CC-Ian/Digital-D20/Mainboard/mainboard.kicad_pcb

## KiCad design Mainboard/mainboard.kicad_pcb (2025-07-16)

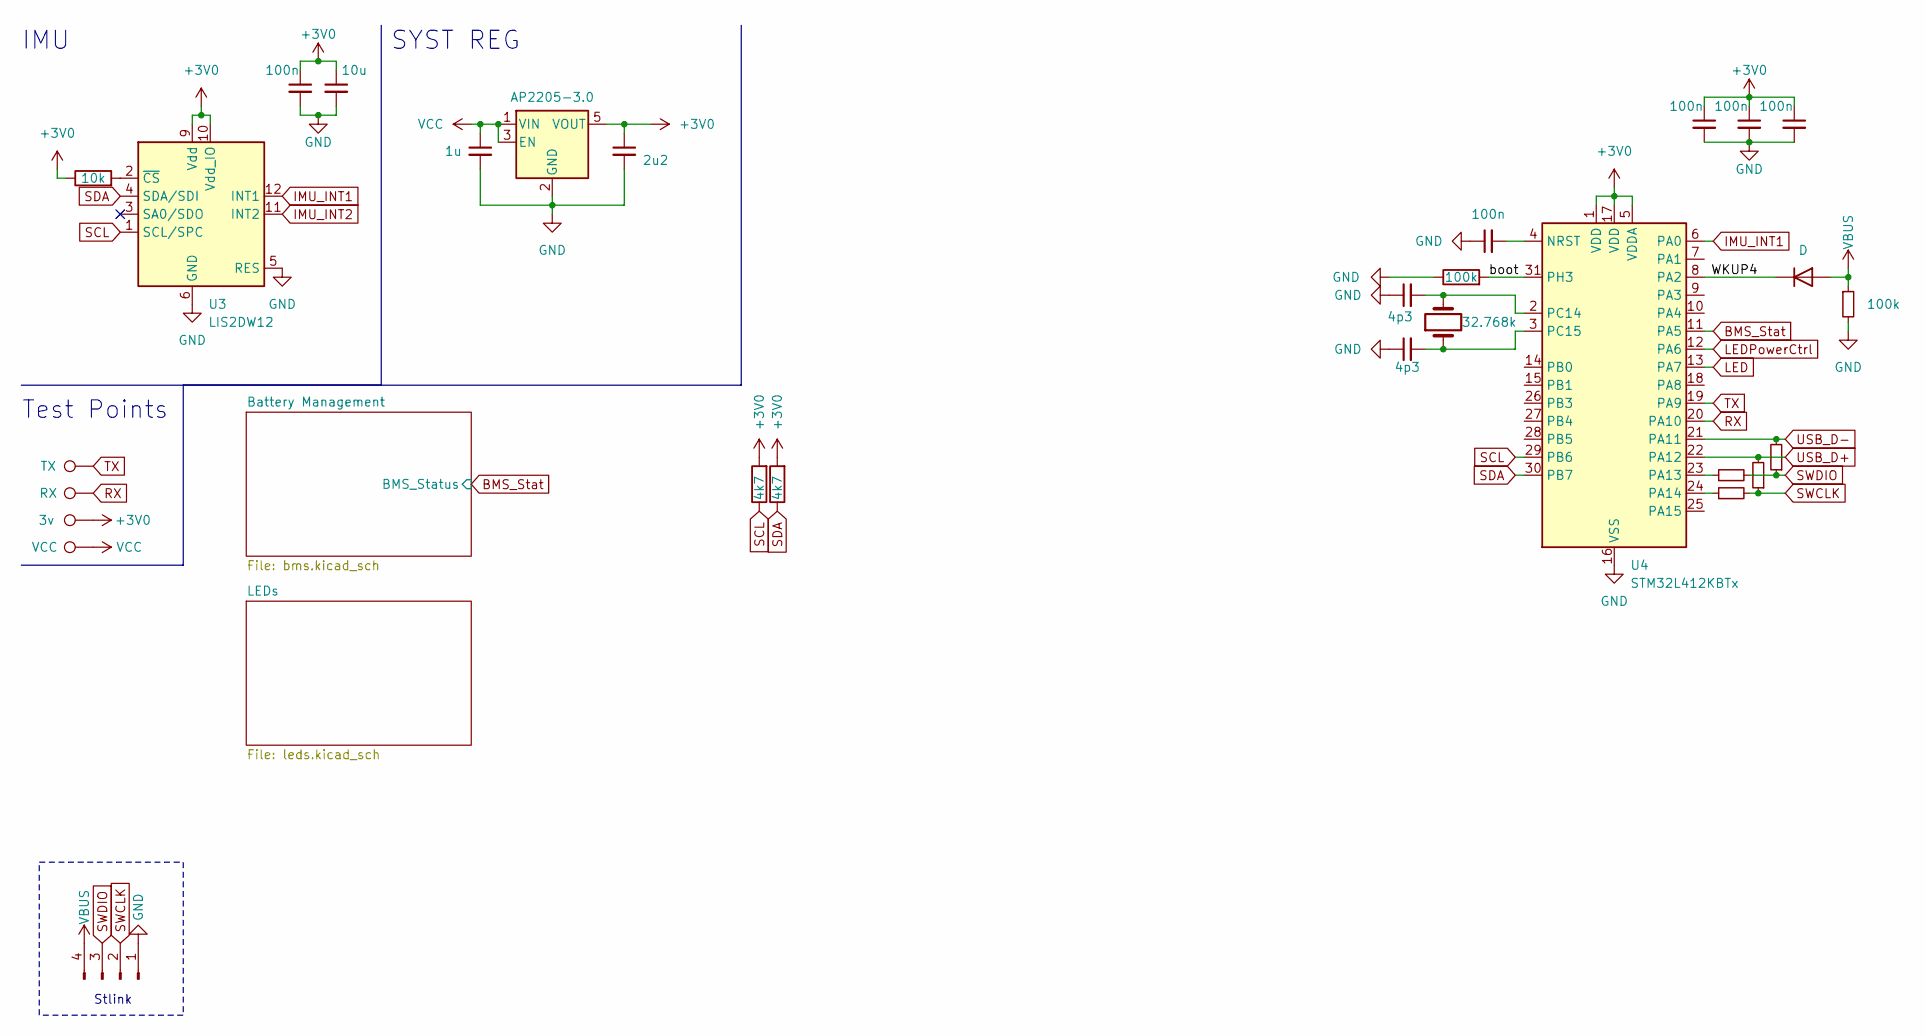
[picture p1: schematic mainboard.kicad_sch]

Parts:
3v0: 3v; TestPoint_Pad_D1.0mm
C3, C5, C6, C7, C10: 100n; C_0402_1005Metric
C4: 10u; C_0402_1005Metric
C8: 1u; C_0402_1005Metric
C9: 2u2; C_0402_1005Metric
C12, C13: 4p3; C_0402_1005Metric
D33: D; D_SOD-323
J1: Conn_01x04_Pin; PinHeader_1x04_P2.54mm_Vertical
R2: 10k; R_0402_1005Metric
R3, R12: R_Small; R_0201_0603Metric
R4, R10: 100k; R_0402_1005Metric
R6, R7: 4k7; R_0402_1005Metric
R13, R14: R_Small; R_0402_1005Metric
RX1: RX; TestPoint_Pad_D1.0mm
TP9: VCC; TestPoint_Pad_D1.0mm
TX1: TX; TestPoint_Pad_D1.0mm
U1: AP2205-3.0; SOT-23-5
U3: LIS2DW12; LGA-12_2x2mm_P0.5mm
U4: STM32L412KBTx; LQFP-32_7x7mm_P0.8mm
Y1: 32.768k; Crystal_SMD_3215-2Pin_3.2x1.5mm

Connections:
+3V0: 3v0.1, C3.1, C4.1, C5.1, C6.1, C7.1, C9.1, R2.1, R6.2, R7.2, U1.5 (VOUT), U3.9 (Vdd), U3.10 (Vdd_IO), U4.1 (VDD), U4.5 (VDDA), U4.17 (VDD)
/WKUP4: D33.1 (K), U4.8 (PA2)
/boot: R4.2, U4.31 (PH3)
BMS_Stat: U4.11 (PA5); also elsewhere on the board
GND: C3.2, C4.2, C5.2, C6.2, C7.2, C8.2, C9.2, C10.1, C12.1, C13.1, J1.1, R4.1, R10.2, U1.2 (GND), U3.5 (RES), U3.6 (GND), U3.7 (GND), U3.8 (GND), U4.16 (VSS), U4.32 (VSS); also elsewhere on the board
IMU_INT1: U3.12 (INT1), U4.6 (PA0)
IMU_INT2: U3.11 (INT2)
LED: U4.13 (PA7); also elsewhere on the board
LEDPowerCtrl: U4.12 (PA6); also elsewhere on the board
unnamed: R2.2, U3.2 (~CS)
unnamed: C10.2, U4.4 (NRST)
unnamed: R3.1, U4.23 (PA13)
unnamed: R12.1, U4.24 (PA14)
unnamed: C12.2, U4.2 (PC14), Y1.2
unnamed: C13.2, U4.3 (PC15), Y1.1
RX: RX1.1, U4.20 (PA10)
SCL: R6.1, U3.1 (SCL/SPC), U4.29 (PB6)
SDA: R7.1, U3.4 (SDA/SDI), U4.30 (PB7)
SWCLK: J1.2, R12.2, R13.1
SWDIO: J1.3, R3.2, R14.1
TX: TX1.1, U4.19 (PA9)
USB_D+: R13.2, U4.22 (PA12)
USB_D-: R14.2, U4.21 (PA11)
VBUS: D33.2 (A), J1.4, R10.1; also elsewhere on the board
VCC: C8.1, TP9.1, U1.1 (VIN), U1.3 (EN); also elsewhere on the board

Notes on the sheet:
Test Points
SYST REG
Stlink
IMU

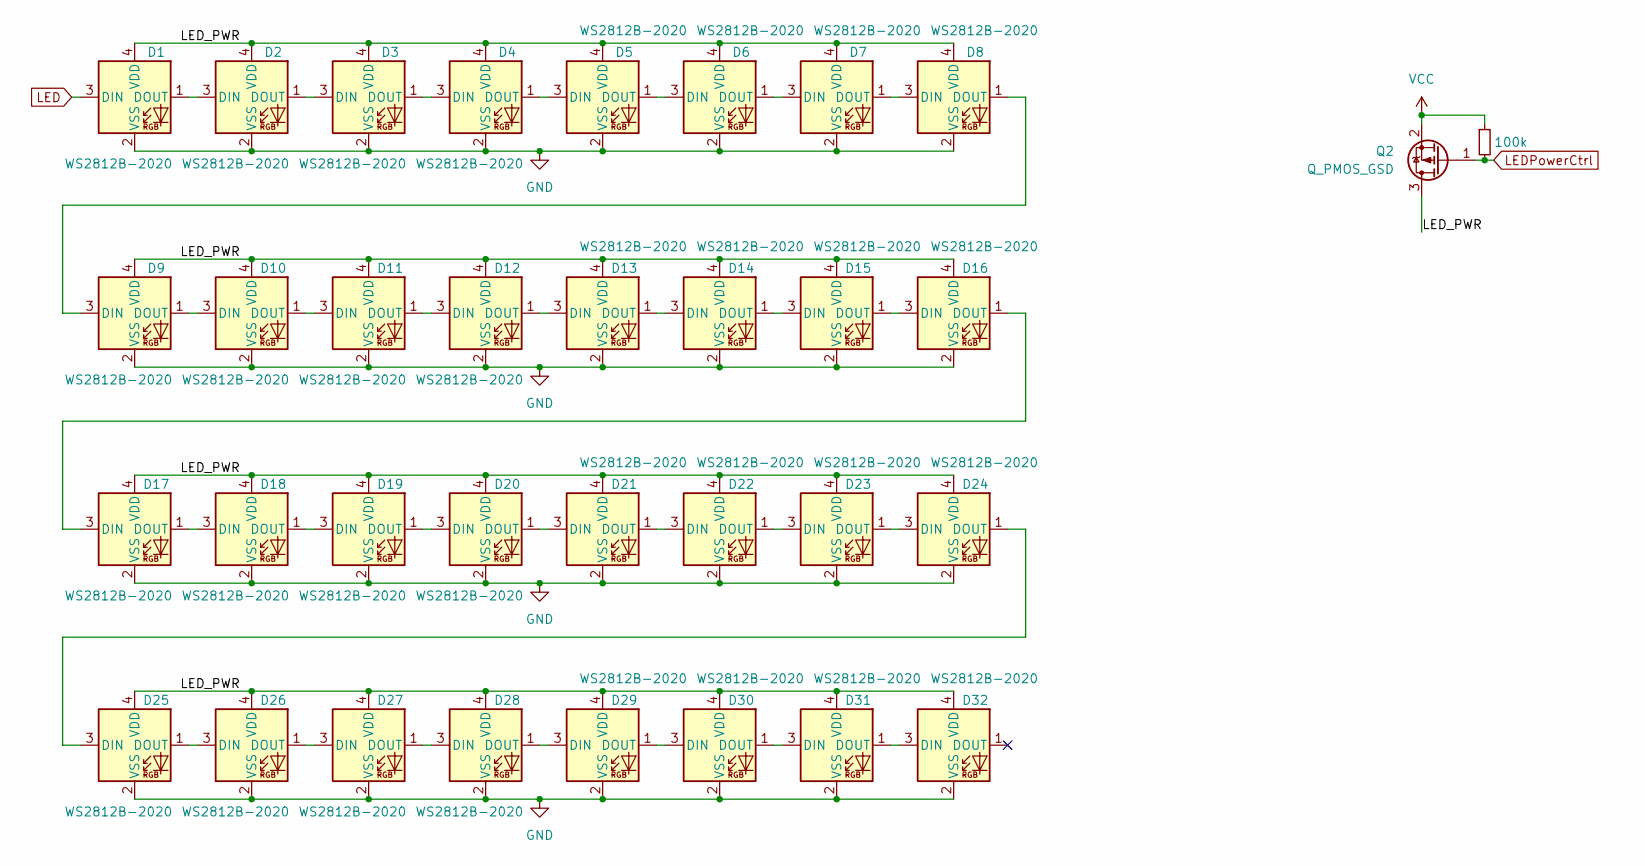
[picture p2: schematic leds.kicad_sch]

Parts:
D1, D2, D3, D4, D5, D6, D7, D8, D9, D10, D11, D12, D13, D14, D15, D16, D17, D18, D19, D20, D21, D22, D23, D24, D25, D26, D27, D28, D29, D30, D31, D32: WS2812B-2020; LED_WS2812B-2020_PLCC4_2.0x2.0mm
Q2: Q_PMOS_GSD; SOT-23
R9: 100k; R_0402_1005Metric

Connections:
/LEDs/LED_PWR: D1.4 (VDD), D2.4 (VDD), D3.4 (VDD), D4.4 (VDD), D5.4 (VDD), D6.4 (VDD), D7.4 (VDD), D8.4 (VDD), D9.4 (VDD), D10.4 (VDD), D11.4 (VDD), D12.4 (VDD), D13.4 (VDD), D14.4 (VDD), D15.4 (VDD), D16.4 (VDD), D17.4 (VDD), D18.4 (VDD), D19.4 (VDD), D20.4 (VDD), D21.4 (VDD), D22.4 (VDD), D23.4 (VDD), D24.4 (VDD), D25.4 (VDD), D26.4 (VDD), D27.4 (VDD), D28.4 (VDD), D29.4 (VDD), D30.4 (VDD), D31.4 (VDD), D32.4 (VDD), Q2.3 (D)
GND: D1.2 (VSS), D2.2 (VSS), D3.2 (VSS), D4.2 (VSS), D5.2 (VSS), D6.2 (VSS), D7.2 (VSS), D8.2 (VSS), D9.2 (VSS), D10.2 (VSS), D11.2 (VSS), D12.2 (VSS), D13.2 (VSS), D14.2 (VSS), D15.2 (VSS), D16.2 (VSS), D17.2 (VSS), D18.2 (VSS), D19.2 (VSS), D20.2 (VSS), D21.2 (VSS), D22.2 (VSS), D23.2 (VSS), D24.2 (VSS), D25.2 (VSS), D26.2 (VSS), D27.2 (VSS), D28.2 (VSS), D29.2 (VSS), D30.2 (VSS), D31.2 (VSS), D32.2 (VSS); also elsewhere on the board
LED: D1.3 (DIN); also elsewhere on the board
LEDPowerCtrl: Q2.1 (G), R9.2; also elsewhere on the board
unnamed: D1.1 (DOUT), D2.3 (DIN)
unnamed: D2.1 (DOUT), D3.3 (DIN)
unnamed: D3.1 (DOUT), D4.3 (DIN)
unnamed: D4.1 (DOUT), D5.3 (DIN)
unnamed: D5.1 (DOUT), D6.3 (DIN)
unnamed: D6.1 (DOUT), D7.3 (DIN)
unnamed: D7.1 (DOUT), D8.3 (DIN)
unnamed: D8.1 (DOUT), D9.3 (DIN)
unnamed: D9.1 (DOUT), D10.3 (DIN)
unnamed: D10.1 (DOUT), D11.3 (DIN)
unnamed: D11.1 (DOUT), D12.3 (DIN)
unnamed: D12.1 (DOUT), D13.3 (DIN)
unnamed: D13.1 (DOUT), D14.3 (DIN)
unnamed: D14.1 (DOUT), D15.3 (DIN)
unnamed: D15.1 (DOUT), D16.3 (DIN)
unnamed: D16.1 (DOUT), D17.3 (DIN)
unnamed: D17.1 (DOUT), D18.3 (DIN)
unnamed: D18.1 (DOUT), D19.3 (DIN)
unnamed: D19.1 (DOUT), D20.3 (DIN)
unnamed: D20.1 (DOUT), D21.3 (DIN)
unnamed: D21.1 (DOUT), D22.3 (DIN)
unnamed: D22.1 (DOUT), D23.3 (DIN)
unnamed: D23.1 (DOUT), D24.3 (DIN)
unnamed: D24.1 (DOUT), D25.3 (DIN)
unnamed: D25.1 (DOUT), D26.3 (DIN)
unnamed: D26.1 (DOUT), D27.3 (DIN)
unnamed: D27.1 (DOUT), D28.3 (DIN)
unnamed: D28.1 (DOUT), D29.3 (DIN)
unnamed: D29.1 (DOUT), D30.3 (DIN)
unnamed: D30.1 (DOUT), D31.3 (DIN)
unnamed: D31.1 (DOUT), D32.3 (DIN)
VCC: Q2.2 (S), R9.1; also elsewhere on the board

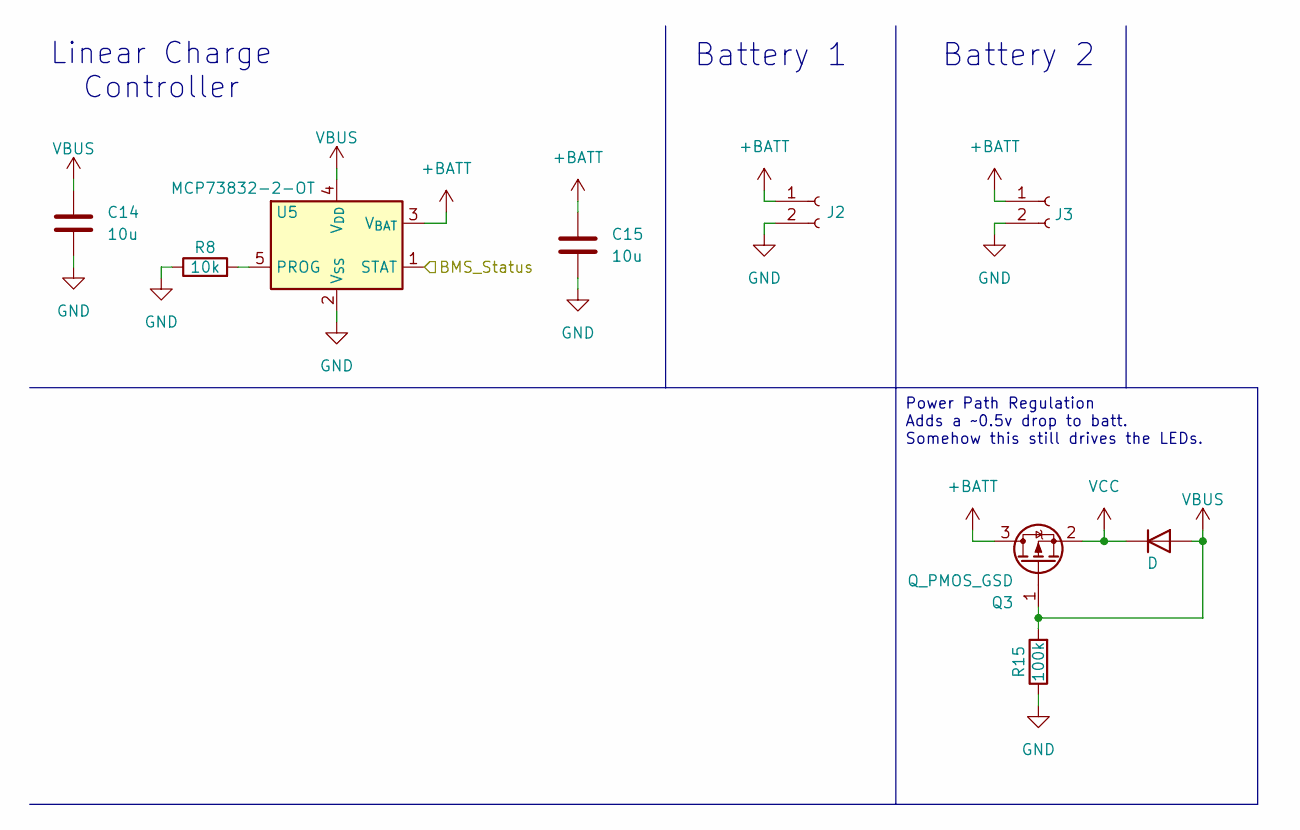
[picture p3: schematic bms.kicad_sch]

Parts:
C14, C15: 10u; C_0603_1608Metric
D34: D; D_SOD-323
J2, J3: Conn_01x02_Socket; PinHeader_1x02_P2.00mm_Vertical
Q3: Q_PMOS_GSD; SOT-23
R8: 10k; R_0402_1005Metric
R15: 100k; R_0402_1005Metric
U5: MCP73832-2-OT; SOT-23-5

Connections:
+BATT: C15.1, J2.1, J3.1, Q3.3 (D), U5.3 (V_{BAT})
BMS_Stat: U5.1 (STAT); also elsewhere on the board
GND: C14.2, C15.2, J2.2, J3.2, R8.1, R15.1, U5.2 (V_{SS}); also elsewhere on the board
unnamed: R8.2, U5.5 (PROG)
VBUS: C14.1, D34.2 (A), Q3.1 (G), R15.2, U5.4 (V_{DD}); also elsewhere on the board
VCC: D34.1 (K), Q3.2 (S); also elsewhere on the board

Notes on the sheet:
Battery 1
Battery 2
Linear Charge Controller
Power Path Regulation Adds a ~0.5v drop to batt. Somehow this still drives the LEDs.

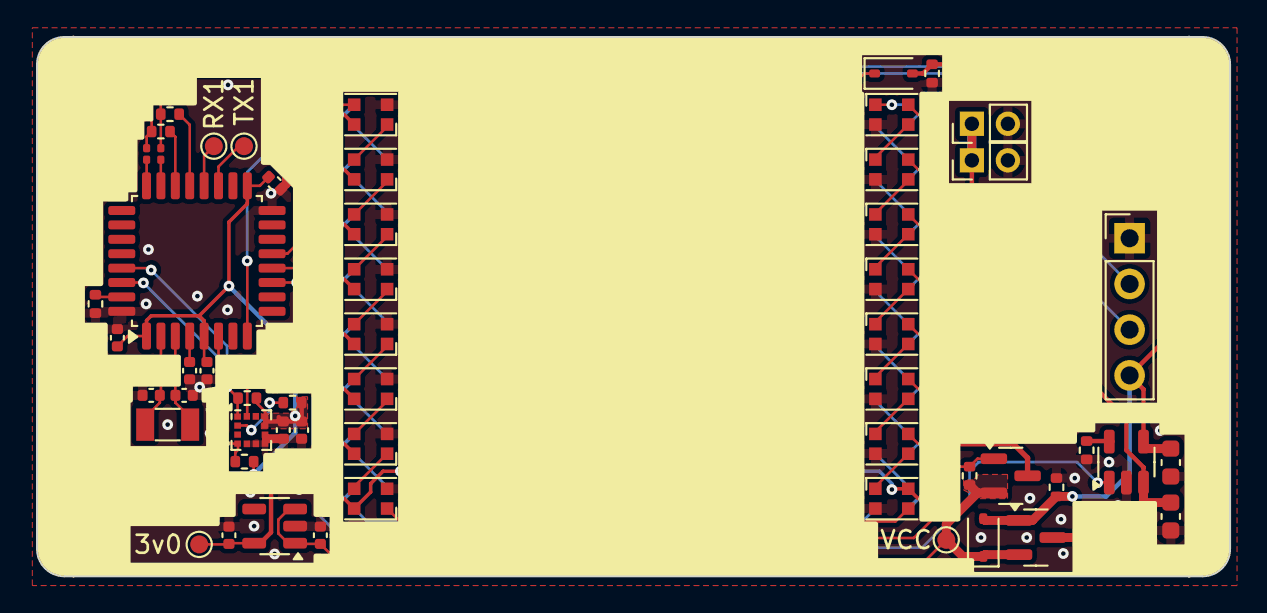
[picture p4: board mainboard.kicad_pcb from above]

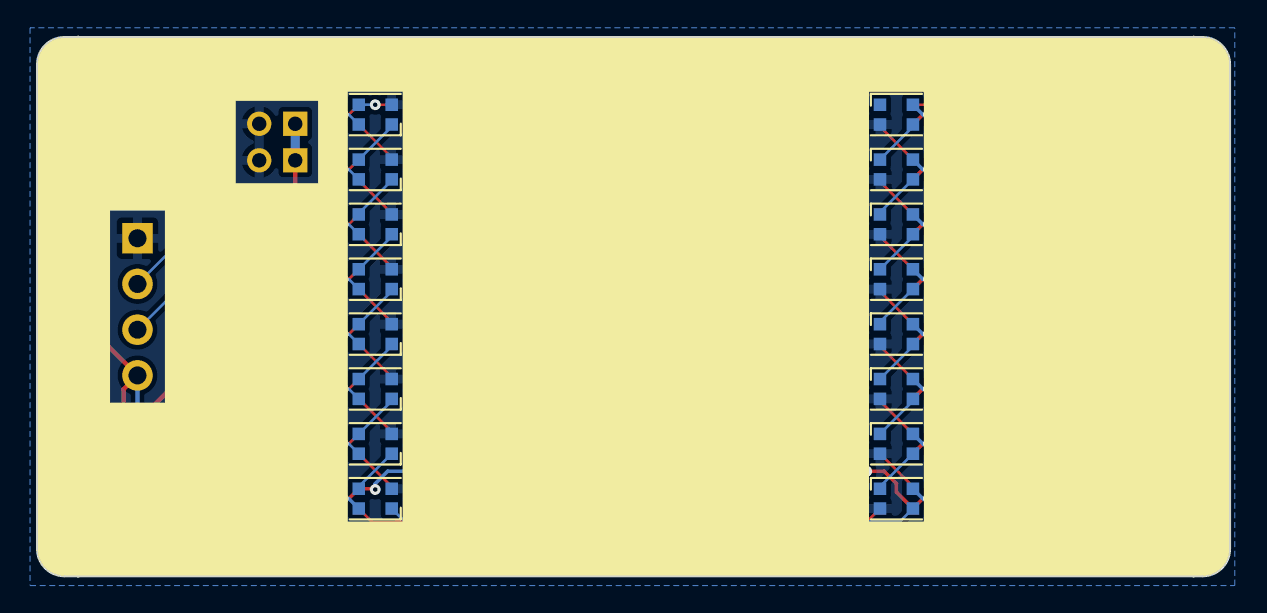
[picture p5: board mainboard.kicad_pcb from below]

Board: 2 copper layers, 66.3 x 30.0 mm, 72 parts (16 on the bottom side), 58 nets.
