CC-Ian/Digital-D20/BaseStation/BaseStation/BaseStation.kicad_pcb

## KiCad design BaseStation/BaseStation/BaseStation.kicad_pcb (2025-01-15)

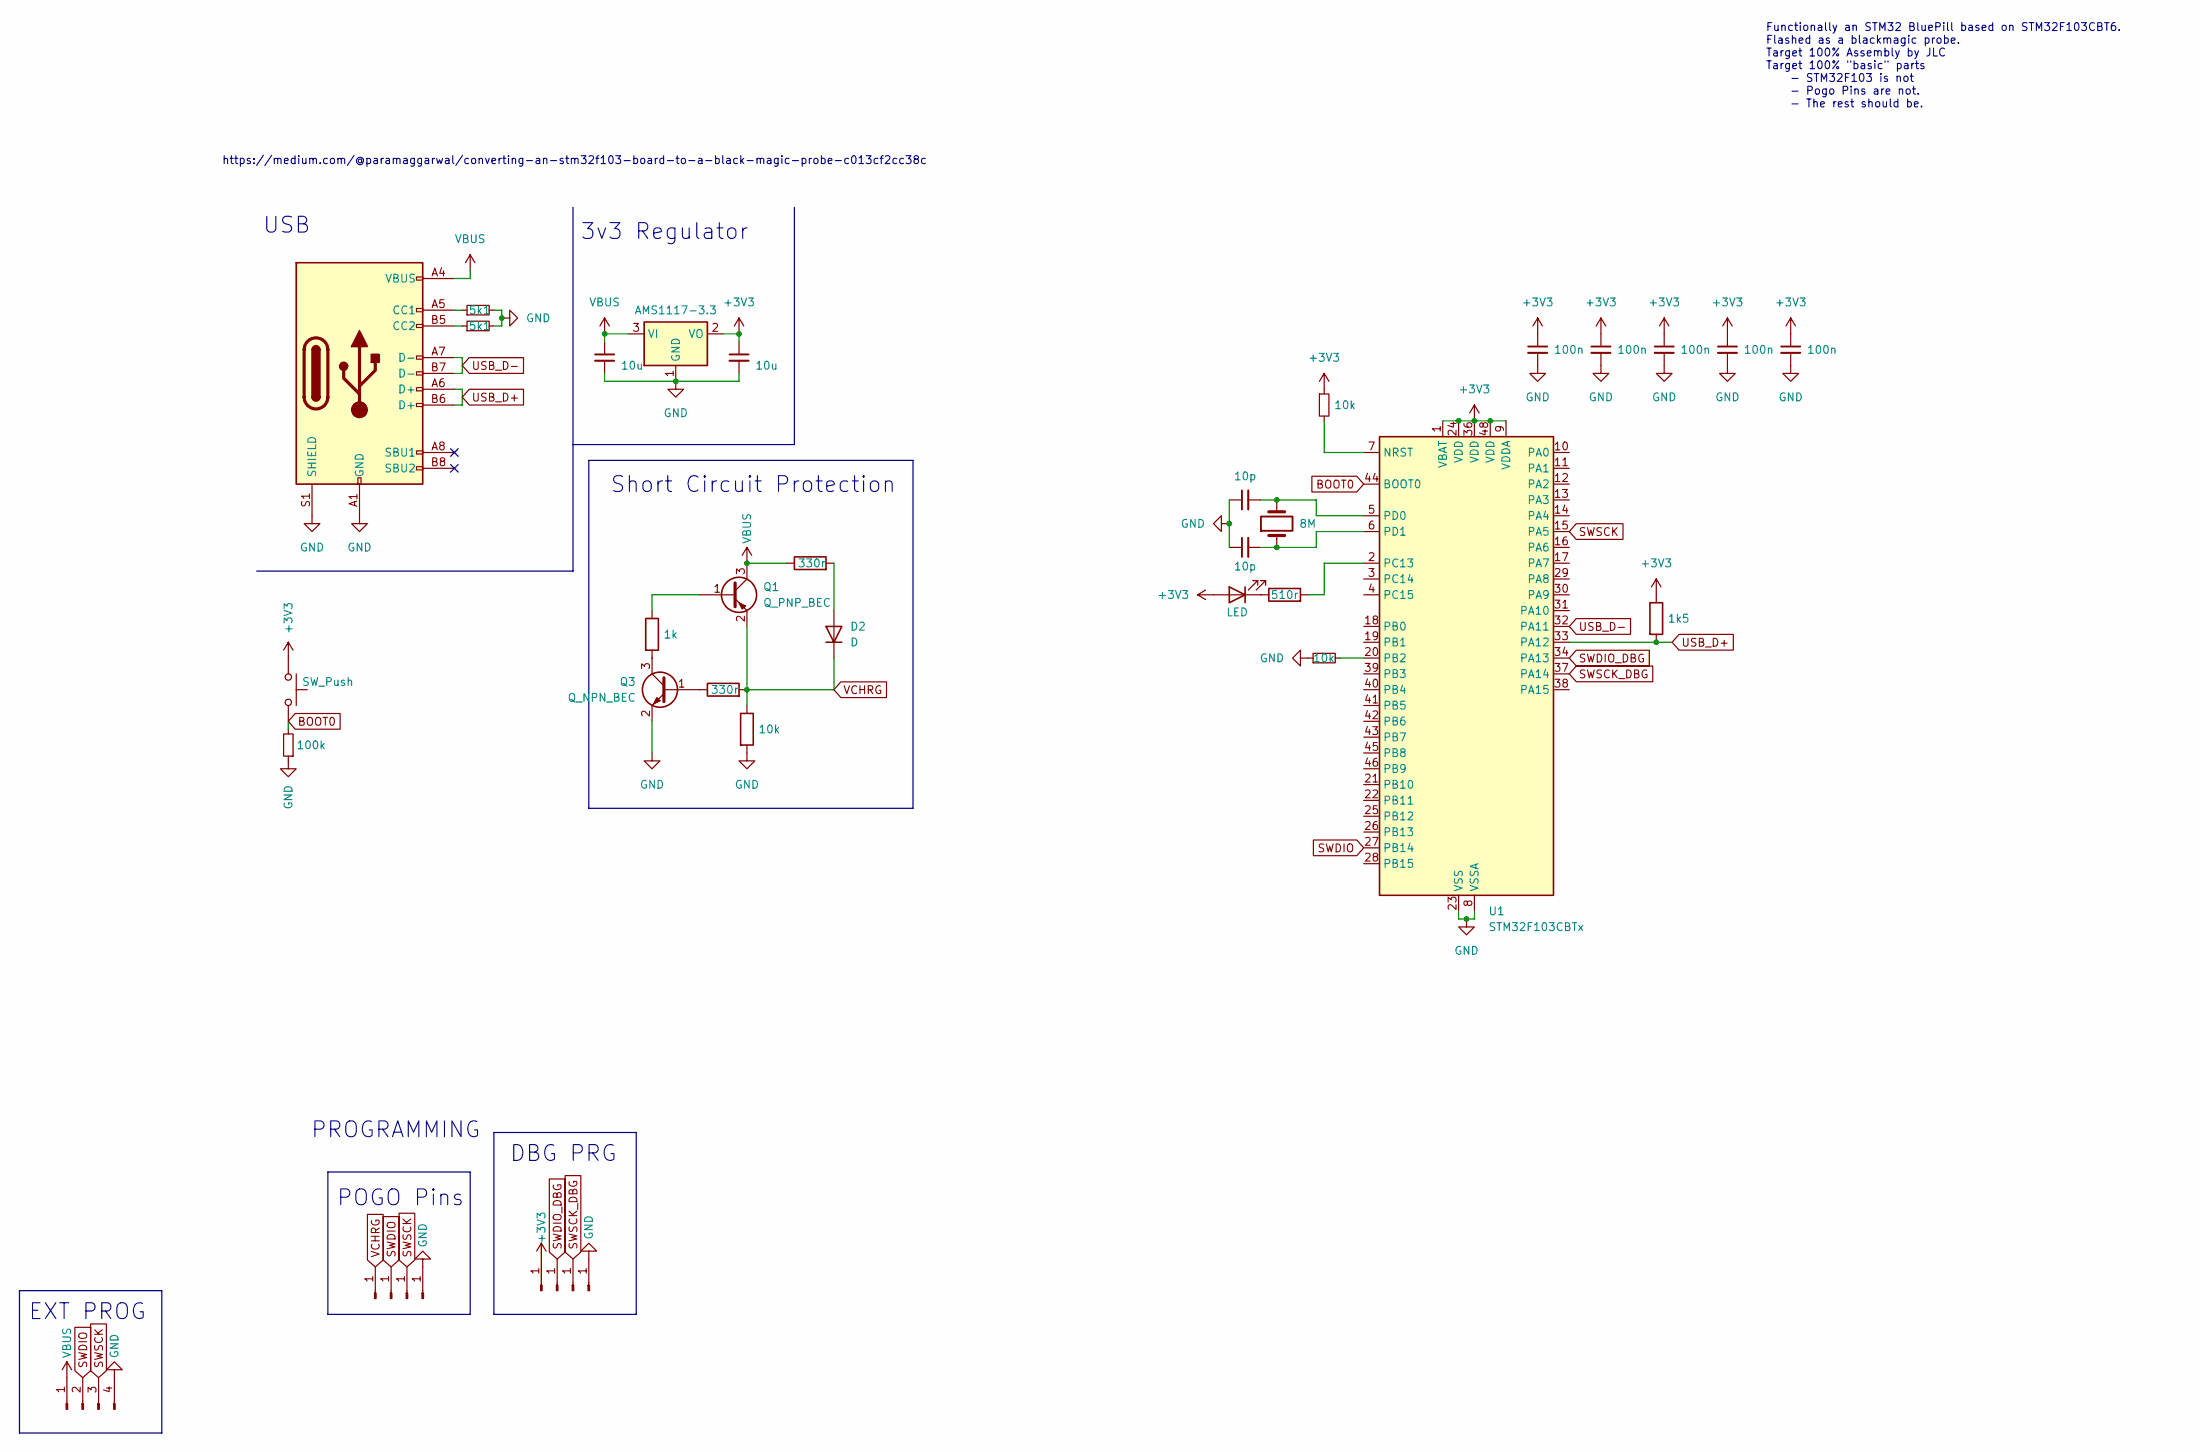
[picture p6: schematic BaseStation.kicad_sch]

Parts:
C1, C2: 10u; C_0603_1608Metric
C3, C4: 10p; C_0402_1005Metric
C5, C6, C7, C8, C9: 100n; C_0402_1005Metric
D1: LED; LED_0603_1608Metric
D2: D; D_SOD-323
J1: USB_C_Receptacle_USB2.0_16P; USB_C_Receptacle_HRO_TYPE-C-31-M-12
J2, J3, J4, J5: Conn_01x01_Pin; TestPoint_Loop_D3.50mm_Drill0.9mm_Beaded
J6, J7, J8, J9: Conn_01x01_Pin; TestPoint_Pad_D1.5mm
J10: Conn_01x04_Pin; PinHeader_1x04_P2.54mm_Horizontal
Q1: Q_PNP_BEC; SOT-23
Q3: Q_NPN_BEC; SOT-23
R1, R2: 5k1; R_0603_1608Metric
R3, R4: 10k; R_0603_1608Metric
R5: 100k; R_0603_1608Metric
R6: 510r; R_0603_1608Metric
R7: 1k; R_0402_1005Metric
R8, R10: 330r; R_0402_1005Metric
R9: 10k; R_0402_1005Metric
R11: 1k5; R_0402_1005Metric
SW1: SW_Push; SW_SPST_SKQG_WithStem
U1: STM32F103CBTx; LQFP-48_7x7mm_P0.5mm
U2: AMS1117-3.3; SOT-223-3_TabPin2
Y2: 8M; Crystal_SMD_5032-2Pin_5.0x3.2mm; Part X50328MSB2GI

Connections:
+3V3: C2.1, C5.1, C6.1, C7.1, C8.1, C9.1, D1.2 (A), J6.1, R3.1, R11.1, SW1.1, U1.1 (VBAT), U1.9 (VDDA), U1.24 (VDD), U1.36 (VDD), U1.48 (VDD), U2.2 (VO)
BOOT0: R5.2, SW1.2, U1.44 (BOOT0)
GND: C1.2, C2.2, C3.1, C4.1, C5.2, C6.2, C7.2, C8.2, C9.2, J1.A1 (GND), J1.A12 (GND), J1.B1 (GND), J1.B12 (GND), J1.S1 (SHIELD), J5.1, J9.1, J10.4, Q3.2 (E), R1.2, R2.2, R4.1, R5.1, R9.2, U1.8 (VSSA), U1.23 (VSS), U1.35 (VSS), U1.47 (VSS), U2.1 (GND)
unnamed: D1.1 (K), R6.1
unnamed: D2.2 (A), R10.2
unnamed: J1.A5 (CC1), R1.1
unnamed: J1.B5 (CC2), R2.1
unnamed: Q1.1 (B), R7.1
unnamed: Q3.1 (B), R8.1
unnamed: Q3.3 (C), R7.2
unnamed: R3.2, U1.7 (NRST)
unnamed: R4.2, U1.20 (PB2)
unnamed: R6.2, U1.2 (PC13)
unnamed: C3.2, U1.5 (PD0), Y2.2
unnamed: C4.2, U1.6 (PD1), Y2.1
SWDIO: J3.1, J10.2, U1.27 (PB14), U1.28 (PB15)
SWDIO_DBG: J7.1, U1.34 (PA13)
SWSCK: J4.1, J10.3, U1.15 (PA5)
SWSCK_DBG: J8.1, U1.37 (PA14)
USB_D+: J1.A6 (D+), J1.B6 (D+), R11.2, U1.33 (PA12)
USB_D-: J1.A7 (D-), J1.B7 (D-), U1.32 (PA11)
VBUS: C1.1, J1.A4 (VBUS), J1.A9 (VBUS), J1.B4 (VBUS), J1.B9 (VBUS), J10.1, Q1.3 (C), R10.1, U2.3 (VI)
VCHRG: D2.1 (K), J2.1, Q1.2 (E), R8.2, R9.1

Notes on the sheet:
DBG PRG
3v3 Regulator
Short Circuit Protection
USB
https://medium.com/@paramaggarwal/converting-an-stm32f103-board-to-a-black-magic-probe-c013cf2cc38c
PROGRAMMING
EXT PROG
Functionally an STM32 BluePill based on STM32F103CBT6. Flashed as a blackmagic probe. Target 100% Assembly by JLC Target 100% "basic" parts - STM32F103 is not - Pogo Pins are not. - The rest should be.
POGO Pins

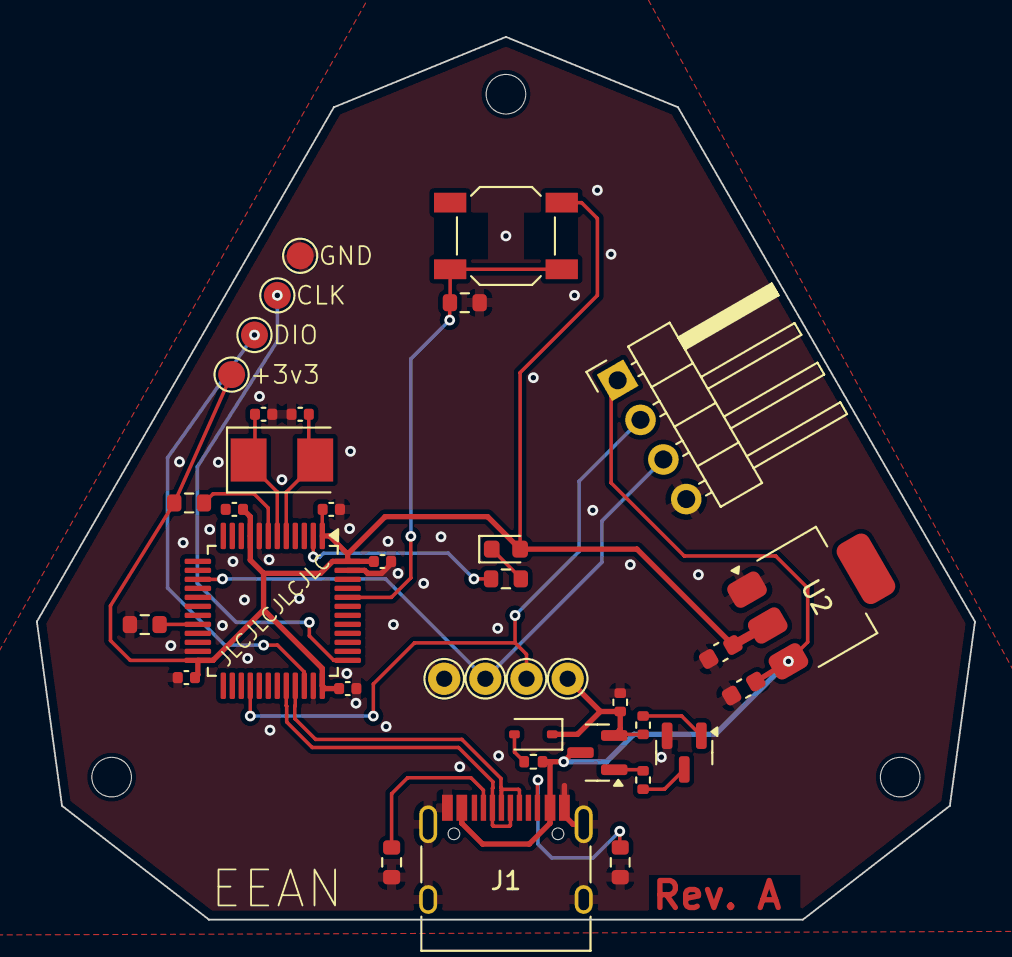
[picture p7: board BaseStation.kicad_pcb from above]

Board: 2 copper layers, 52.1 x 49.0 mm, 37 parts (0 on the bottom side), 23 nets.
