CC-Ian/Digital-D20/Mainboard/mainboard_copy Mar 12.kicad_pcb

## KiCad design Mainboard/mainboard_copy Mar 12.kicad_pcb (2024-03-13)

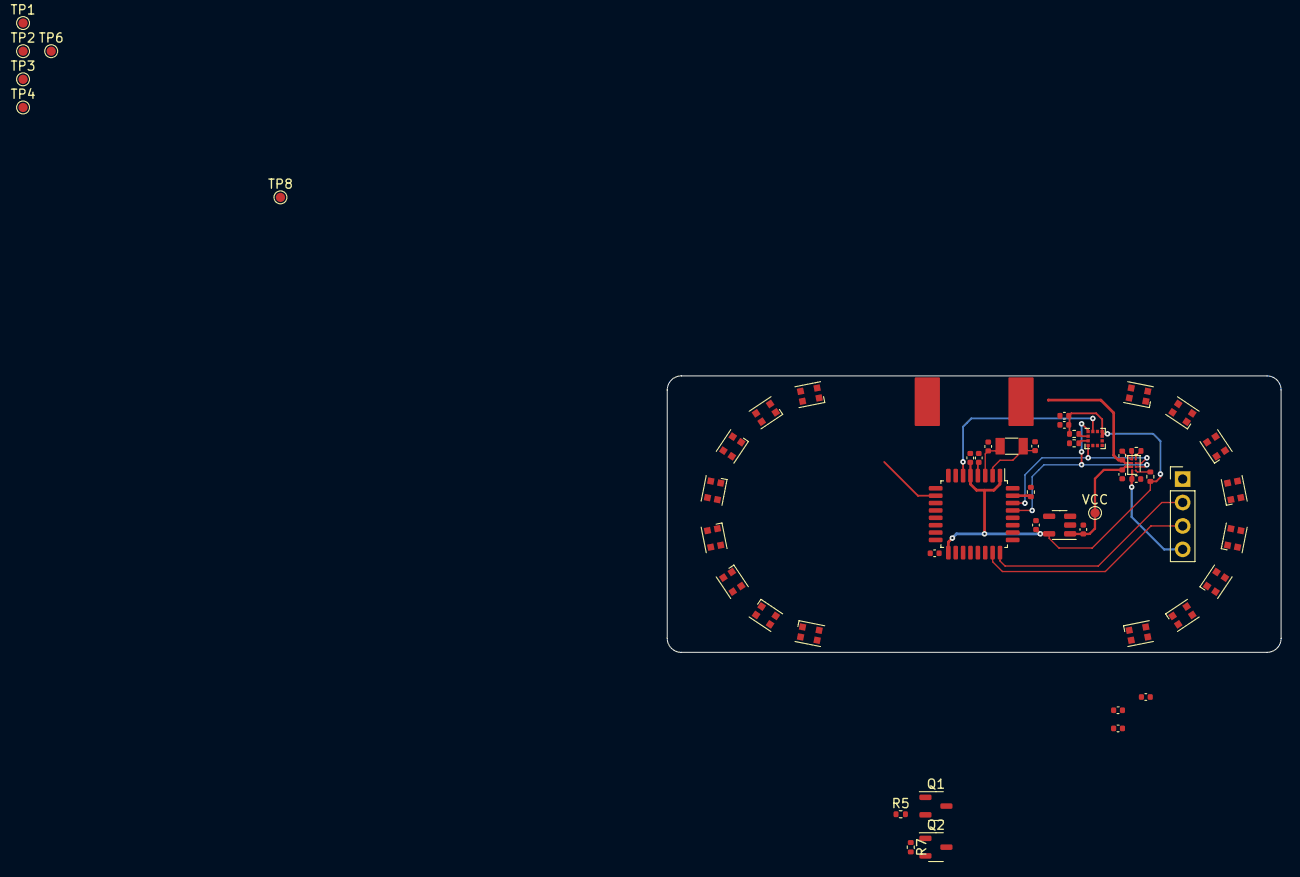
[picture p8: board mainboard_copy Mar 12.kicad_pcb from above]

Board: 2 copper layers, 66.5 x 30.0 mm, 37 parts (0 on the bottom side), 21 nets.

Parts:
C1: 2u2; C_0402_1005Metric
C2, C5, C6: 1u; C_0402_1005Metric
C3, C7: 10u; C_0402_1005Metric
C4, C8, C9, C10, C13, C14, C15: 100n; C_0402_1005Metric
C11, C12: 4p3; C_0402_1005Metric
J1: Conn_01x04_Pin; PinHeader_1x04_P2.54mm_Vertical
Q1, Q2: PMOS; SOT-23-3
R1, R3, R4, R6: 10k; R_0402_1005Metric
R2: 0; R_0402_1005Metric
R5, R7: 100k; R_0402_1005Metric
TP1: SDA; TestPoint_Pad_D1.0mm
TP2: SCL; TestPoint_Pad_D1.0mm
TP3: INT1; TestPoint_Pad_D1.0mm
TP4: INT2; TestPoint_Pad_D1.0mm
TP6: 3v; TestPoint_Pad_D1.0mm
TP8: GND; TestPoint_Pad_D1.0mm
U1: LIS2DW12; LGA-12_2x2mm_P0.5mm
U2: AP2205-3.0; SOT-23-5
U3: BQ21080; Texas_DSBGA-8-1.04x1.59mm
U4: STM32L412KBTx; LQFP-32_7x7mm_P0.8mm
VCC: VCC; TestPoint_Pad_D1.0mm
Y1: 32.768k; Crystal_SMD_3215-2Pin_3.2x1.5mm

Connections:
+3V0: C1.1, C3.1, C4.1, C8.1, C9.1, C13.1, C14.1, C15.1, Q1.3 (S), Q2.3 (S), R1.1, R4.2, R5.1, R7.1, TP6.1, U1.9 (Vdd), U1.10 (Vdd_IO), U2.5 (VOUT), U4.1 (VDD), U4.5 (VDDA), U4.17 (VDD)
+BATT: C5.1, U3.C2 (BAT)
BH1730PowerCtrl: Q1.2 (G), R5.2, U4.13 (PA7)
GND: C1.2, C2.2, C3.2, C4.2, C5.2, C6.2, C7.2, C8.2, C9.2, C10.1, C11.1, C12.1, C13.2, C14.2, C15.2, J1.1, R2.1, R3.1, R6.1, TP8.1, U1.5 (RES), U1.6 (GND), U1.7 (GND), U1.8 (GND), U2.2 (GND), U2.3 (EN), U3.D2 (GND), U4.16 (VSS), U4.32 (VSS)
IMU_INT1: TP3.1, U1.12 (INT1), U4.6 (PA0)
IMU_INT2: TP4.1, U1.11 (INT2)
LEDP0werCtrl: Q2.2 (G), R7.2
unnamed: R2.2, U1.3 (SA0/SDO)
unnamed: R1.2, U1.2 (~CS)
unnamed: C10.2, U4.4 (NRST)
unnamed: C11.2, U4.2 (PC14), Y1.2
unnamed: C12.2, U4.3 (PC15), Y1.1
unnamed: R6.2, U4.31 (PH3)
SCL: TP2.1, U1.1 (SCL/SPC), U3.B1 (SCL), U4.29 (PB6)
SDA: TP1.1, U1.4 (SDA/SDI), U3.C1 (SDA), U4.30 (PB7)
SWCLK: J1.2, U4.24 (PA14)
SWDIO: J1.3, U4.23 (PA13)
TS|MR: R3.2, U3.D1 (TS|MR)
VBUS: C6.1, J1.4, U3.A2 (IN)
VCC: C2.1, C7.1, U2.1 (VIN), U3.B2 (SYS), VCC.1
~BMS_INT: R4.1, U3.A1 (~INT)
